restelli/aom-driver/kicad/aom_simple_1.kicad_sch

## KiCad design kicad/aom_simple_1.kicad_sch (2022-05-25)

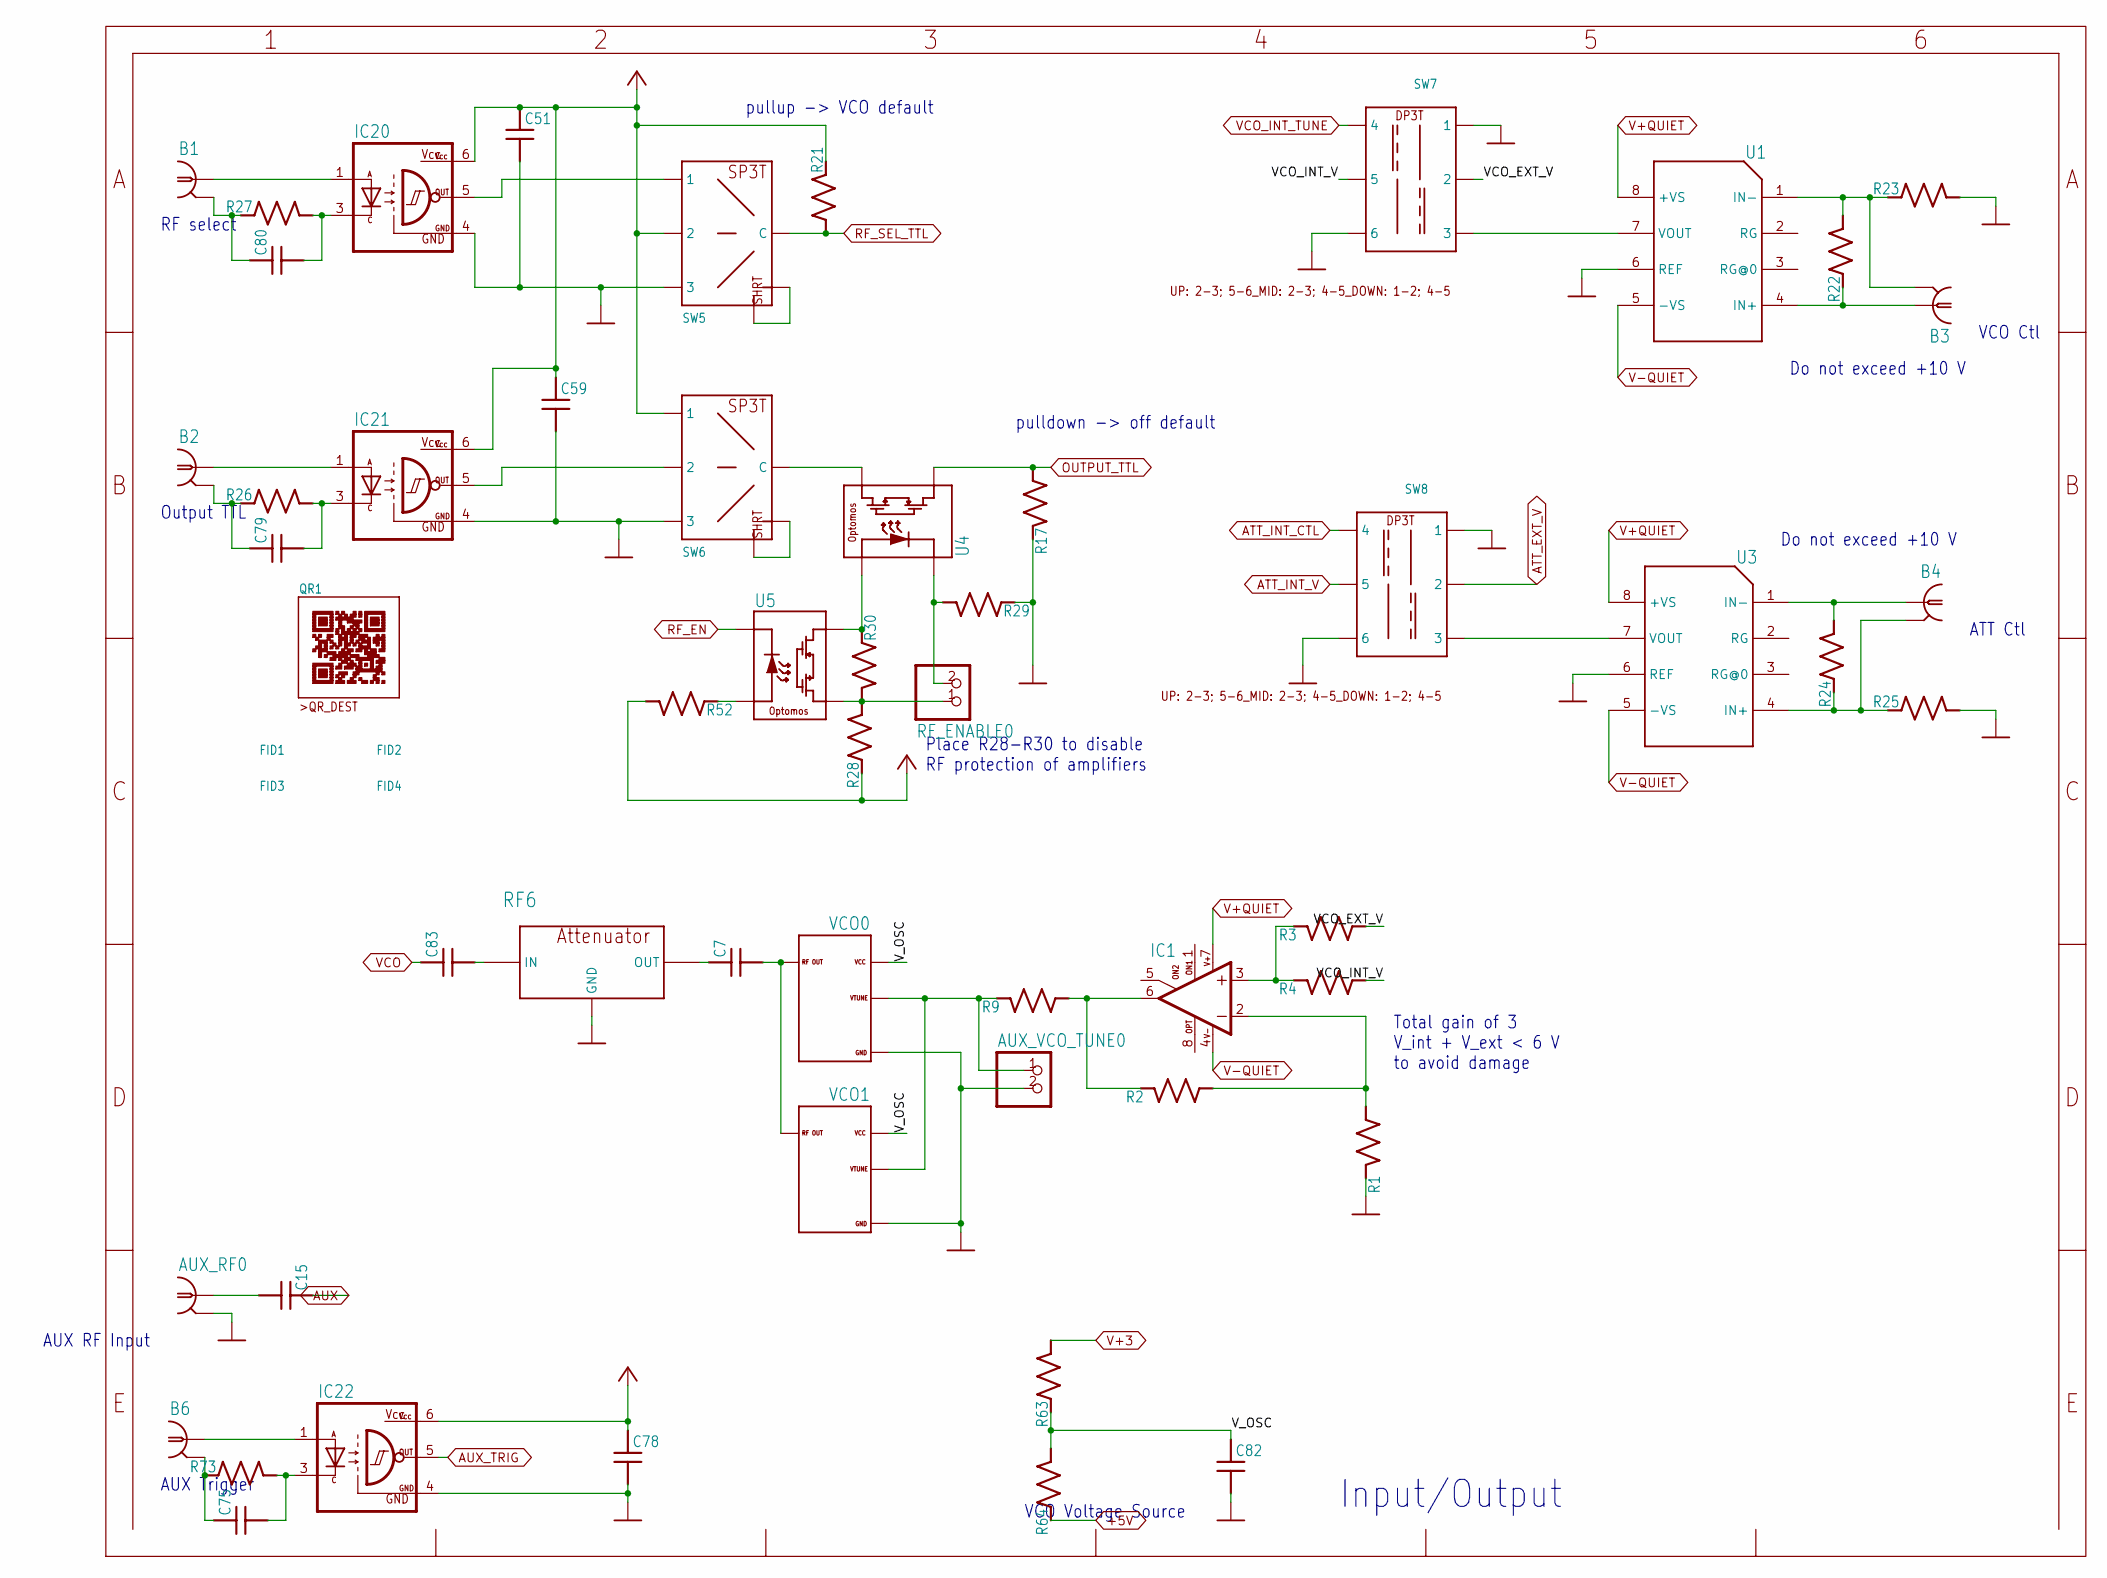
[picture p1: schematic aom_simple_1.kicad_sch]

Parts:
AUX_RF0: (no value)
AUX_VCO_TUNE0: (no value)
B1, B2, B3, B4, B6: (no value)
C7, C15, C51, C59, C75, C78, C79, C80, C82, C83: (no value)
FID1, FID2, FID3, FID4: (no value)
IC1, IC20, IC21, IC22: (no value)
QR1: (no value)
R1, R2, R3, R4, R9, R17, R21, R22, R23, R24, R25, R26, R27, R28, R29, R30, R52, R63, R64, R73: (no value)
RF6: (no value)
RF_ENABLE0: (no value)
SW5, SW6, SW7, SW8: (no value)
U1, U3, U4, U5: (no value)
VCO0, VCO1: (no value)

Connections:
+5V: R64.P$1 (1)
ATT_EXT_V: SW8.2
ATT_INT_CTL: SW8.4
ATT_INT_V: SW8.5
AUX: C15.P$1 (1)
AUX_TRIG: IC22.5 (OUT)
unnamed: AUX_RF0.GND1 (2), AUX_RF0.GND2 (2), AUX_RF0.GND3 (2), AUX_RF0.GND4 (2), AUX_VCO_TUNE0.2, C51.P$1 (1), C51.P$2 (2), C59.P$1 (1), C59.P$2 (2), C78.P$1 (1), C78.P$2 (2), C82.P$2 (2), IC20.4 (GND), IC20.6 (VCC), IC21.4 (GND), IC21.6 (VCC), IC22.4 (GND), IC22.6 (VCC), R1.P$1 (1), R17.P$1 (1), R21.P$1 (1), R23.P$2 (2), R25.P$2 (2), R28.P$1 (1), R29.P$1 (1), R52.P$2 (2), RF6.3 (GND), SW5.1 (3), SW5.4 (2), SW6.1 (3), SW6.6 (1), SW7.1, SW7.6, SW8.1, SW8.6, U1.6 (REF), U3.6 (REF), VCO0.1 (7-GND), VCO0.3 (7-GND), VCO0.4 (7-GND), VCO0.6 (7-GND), VCO0.7 (7-GND), VCO0.8 (7-GND), VCO0.9 (7-GND), VCO0.10 (7-GND), VCO0.11 (7-GND), VCO0.12 (7-GND), VCO0.14 (7-GND), VCO1.1 (7-GND), VCO1.3 (7-GND), VCO1.4 (7-GND), VCO1.5 (7-GND), VCO1.6 (7-GND), VCO1.7 (7-GND), VCO1.8 (7-GND), VCO1.9 (7-GND), VCO1.11 (7-GND), VCO1.12 (7-GND), VCO1.13 (7-GND), VCO1.15 (7-GND), VCO1.16 (7-GND)
unnamed: AUX_RF0.RF (1), C15.P$2 (2)
unnamed: AUX_VCO_TUNE0.1, R9.P$1 (1), VCO0.5 (5-VTUNE), VCO1.2 (5-VTUNE)
unnamed: B1.1, IC20.1 (A)
unnamed: B1.2, C80.P$1 (1), R27.P$1 (1)
unnamed: B2.1, IC21.1 (A)
unnamed: B2.2, C79.P$1 (1), R26.P$1 (1)
unnamed: B3.1, R22.P$1 (1), U1.4 (IN+)
unnamed: B3.2, R22.P$2 (2), R23.P$1 (1), U1.1 (IN-)
unnamed: B4.1, R24.P$2 (2), U3.1 (IN-)
unnamed: B4.2, R24.P$1 (1), R25.P$1 (1), U3.4 (IN+)
unnamed: B6.1, IC22.1 (A)
unnamed: B6.2, C75.P$1 (1), R73.P$1 (1)
unnamed: C7.P$1 (1), RF6.2 (OUT)
unnamed: C7.P$2 (2), VCO0.13 (13-RFOUT), VCO1.10 (13-RFOUT)
unnamed: C75.P$2 (2), IC22.3 (C), R73.P$2 (2)
unnamed: C79.P$2 (2), IC21.3 (C), R26.P$2 (2)
unnamed: C80.P$2 (2), IC20.3 (C), R27.P$2 (2)
unnamed: C83.P$2 (2), RF6.1 (IN)
unnamed: IC1.2 (-IN), R1.P$2 (2), R2.P$2 (2)
unnamed: IC1.3 (+IN), R3.P$1 (1), R4.P$1 (1)
unnamed: IC1.6 (OUT), R2.P$1 (1), R9.P$2 (2)
unnamed: IC20.5 (OUT), SW5.6 (1)
unnamed: IC21.5 (OUT), SW6.4 (2)
unnamed: R28.P$2 (2), R30.P$2 (2), RF_ENABLE0.1, U5.P$4 (L+)
unnamed: R29.P$2 (2), RF_ENABLE0.2, U4.P$2 (C-)
unnamed: R30.P$1 (1), U4.P$1 (C+), U5.P$3 (L-)
unnamed: R52.P$1 (1), U5.P$1 (C+)
unnamed: SW5.3 (D), SW5.5 (E)
unnamed: SW6.2 (C), U4.P$4 (L+)
unnamed: SW6.3 (D), SW6.5 (E)
unnamed: SW7.3, U1.7 (VOUT)
unnamed: SW8.3, U3.7 (VOUT)
OUTPUT_TTL: R17.P$2 (2), U4.P$3 (L-)
RF_EN: U5.P$2 (C-)
RF_SEL_TTL: R21.P$2 (2), SW5.2 (C)
V+3: R63.P$2 (2)
V+QUIET: IC1.7 (V+), U1.8 (+VS), U3.8 (+VS)
V-QUIET: IC1.4 (V-), U1.5 (-VS), U3.5 (-VS)
VCO: C83.P$1 (1)
VCO_EXT_V: R3.P$2 (2), SW7.2
VCO_INT_TUNE: SW7.4
VCO_INT_V: R4.P$2 (2), SW7.5
V_OSC: C82.P$1 (1), R63.P$1 (1), R64.P$2 (2), VCO0.2 (2-VCC), VCO1.14 (2-VCC)

Notes on the sheet:
AUX Trigger
Do not exceed +10 V
AUX RF Input
RF select
ATT Ctl
pullup -> VCO default
VCO Voltage Source
Place R28-R30 to disable RF protection of amplifiers
VCO Ctl
Output TTL
Total gain of 3 V_int + V_ext < 6 V to avoid damage
pulldown -> off default
Input/Output
