restelli/aom-driver/kicad/aom_simple_2.kicad_sch

## KiCad design kicad/aom_simple_2.kicad_sch (2022-05-25)

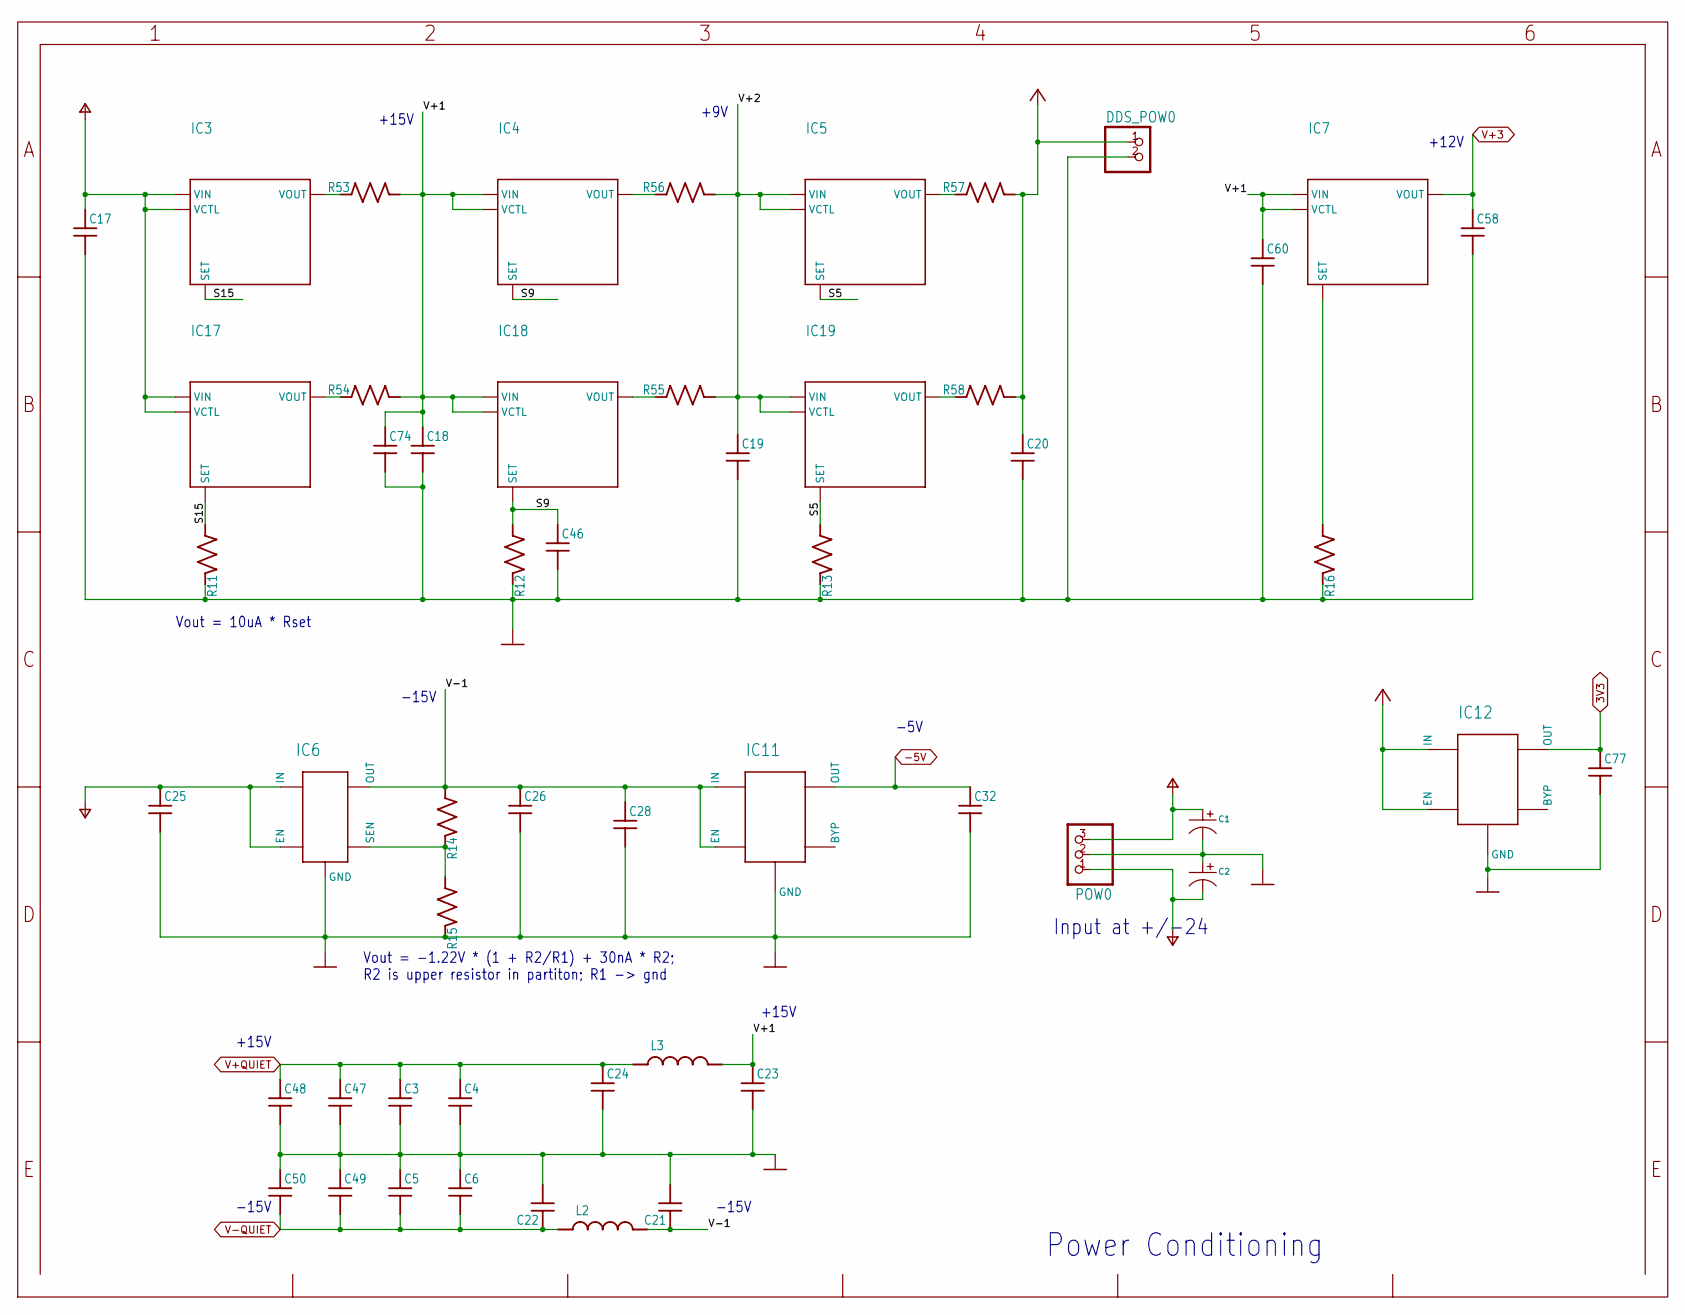
[picture p2: schematic aom_simple_2.kicad_sch]

Parts:
C1, C2, C3, C4, C5, C6, C17, C18, C19, C20, C21, C22, C23, C24, C25, C26, C28, C32, C46, C47, C48, C49, C50, C58, C60, C74, C77: (no value)
DDS_POW0: (no value)
IC3, IC4, IC5, IC6, IC7, IC11, IC12, IC17, IC18, IC19: (no value)
L2, L3: (no value)
POW0: (no value)
R11, R12, R13, R14, R15, R16, R53, R54, R55, R56, R57, R58: (no value)

Connections:
3V3: C77.P$1 (1), IC12.5 (OUT)
-5V: C32.P$1 (1), IC11.5 (OUT)
unnamed: C1.P$1, C1.P$2, C2.P$1, C2.P$2, C3.P$2 (2), C4.P$2 (2), C5.P$1 (1), C6.P$1 (1), C17.P$1 (1), C17.P$2 (2), C18.P$2 (2), C19.P$2 (2), C20.P$1 (1), C20.P$2 (2), C21.P$2 (2), C22.P$2 (2), C23.P$2 (2), C24.P$2 (2), C25.P$1 (1), C25.P$2 (2), C26.P$2 (2), C28.P$2 (2), C32.P$2 (2), C46.P$2 (2), C47.P$2 (2), C48.P$2 (2), C49.P$1 (1), C50.P$1 (1), C58.P$2 (2), C60.P$2 (2), C74.P$2 (2), C77.P$2 (2), DDS_POW0.1, DDS_POW0.2, IC3.4 (VCTL), IC3.5 (VIN), IC6.1 (EN), IC6.2 (GND), IC6.3 (IN), IC6.6 (IN), IC11.1 (GND), IC12.1 (IN), IC12.2 (GND), IC12.3 (EN), IC17.4 (VCTL), IC17.5 (VIN), POW0.1, POW0.2, POW0.3, R11.P$1 (1), R12.P$1 (1), R13.P$1 (1), R15.P$1 (1), R16.P$1 (1), R57.P$2 (2), R58.P$2 (2)
unnamed: IC3.3 (VOUT), IC3.6 (VOUT), R53.P$1 (1)
unnamed: IC4.3 (VOUT), IC4.6 (VOUT), R56.P$1 (1)
unnamed: IC5.3 (VOUT), IC5.6 (VOUT), R57.P$1 (1)
unnamed: IC6.4 (SEN), R14.P$1 (1), R15.P$2 (2)
unnamed: IC7.2 (SET), R16.P$2 (2)
unnamed: IC17.3 (VOUT), IC17.6 (VOUT), R54.P$1 (1)
unnamed: IC18.3 (VOUT), IC18.6 (VOUT), R55.P$1 (1)
unnamed: IC19.3 (VOUT), IC19.6 (VOUT), R58.P$1 (1)
S5: IC5.2 (SET), IC19.2 (SET), R13.P$2 (2)
S9: C46.P$1 (1), IC4.2 (SET), IC18.2 (SET), R12.P$2 (2)
S15: IC3.2 (SET), IC17.2 (SET), R11.P$2 (2)
V+1: C18.P$1 (1), C23.P$1 (1), C60.P$1 (1), C74.P$1 (1), IC4.4 (VCTL), IC4.5 (VIN), IC7.4 (VCTL), IC7.5 (VIN), IC18.4 (VCTL), IC18.5 (VIN), L3.P$2 (2), R53.P$2 (2), R54.P$2 (2)
V+2: C19.P$1 (1), IC5.4 (VCTL), IC5.5 (VIN), IC19.4 (VCTL), IC19.5 (VIN), R55.P$2 (2), R56.P$2 (2)
V+3: C58.P$1 (1), IC7.3 (VOUT), IC7.6 (VOUT)
V+QUIET: C3.P$1 (1), C4.P$1 (1), C24.P$1 (1), C47.P$1 (1), C48.P$1 (1), L3.P$1 (1)
V-1: C21.P$1 (1), C26.P$1 (1), C28.P$1 (1), IC6.5 (OUT), IC11.2 (IN), IC11.4 (EN), L2.P$2 (2), R14.P$2 (2)
V-QUIET: C5.P$2 (2), C6.P$2 (2), C22.P$1 (1), C49.P$2 (2), C50.P$2 (2), L2.P$1 (1)

Notes on the sheet:
Vout = -1.22V * (1 + R2/R1) + 30nA * R2; R2 is upper resistor in partiton; R1 -> gnd
+15V
-15V
Input at +/-24
+12V
Vout = 10uA * Rset
-5V
Power Conditioning
+9V
