restelli/aom-driver/kicad/aom_simple_3.kicad_sch

## KiCad design kicad/aom_simple_3.kicad_sch (2022-05-25)

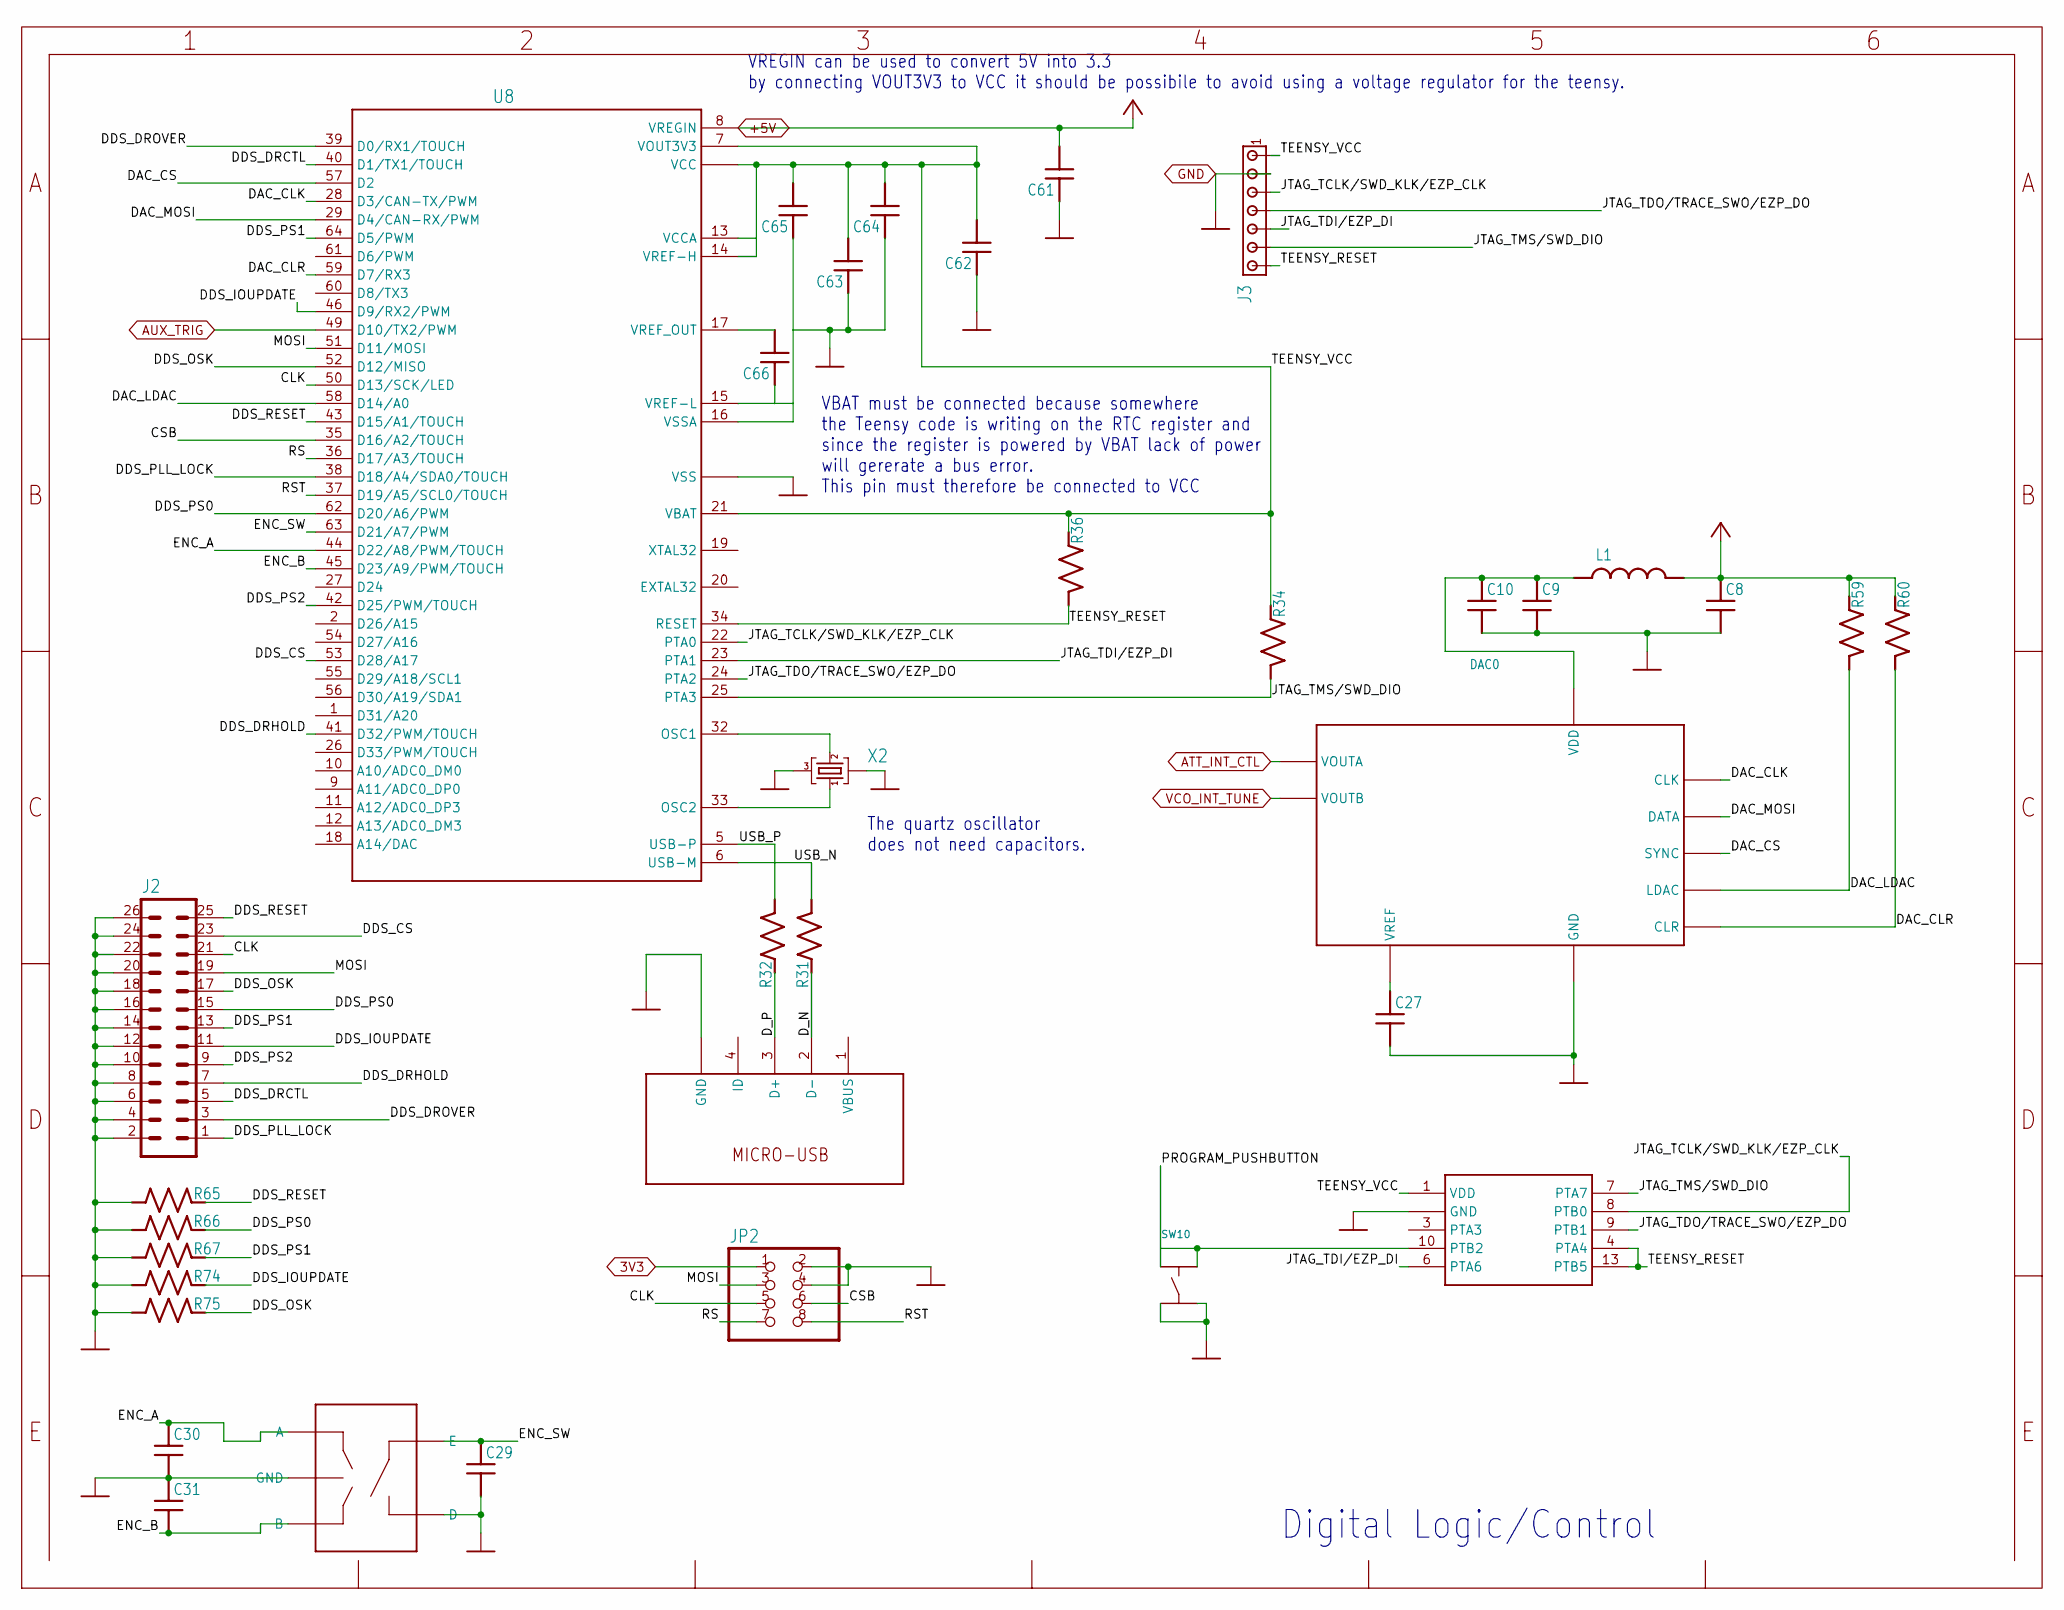
[picture p3: schematic aom_simple_3.kicad_sch]

Parts:
C8, C9, C10, C27, C29, C30, C31, C61, C62, C63, C64, C65, C66: (no value)
DAC0: (no value)
ENC1: (no value)
J2, J3: (no value)
JP2: (no value)
L1: (no value)
R31, R32, R34, R36, R59, R60, R65, R66, R67, R74, R75: (no value)
SW10: (no value)
U8: (no value)
UNK3X3MM1: (no value)
USB1: (no value)
X2: (no value)

Connections:
3V3: JP2.1
+5V: C8.P$1 (1), C8.P$2 (2), C9.P$2 (2), C10.P$2 (2), C27.P$2 (2), C29.P$2 (2), C30.P$2 (2), C31.P$1 (1), C61.P$1 (1), C61.P$2 (2), C62.P$1 (1), C63.P$1 (1), C64.P$1 (1), C65.P$1 (1), C66.P$1 (1), DAC0.3 (GND), ENC1.2 (D), ENC1.C (GND), J2.2, J2.4, J2.6, J2.8, J2.10, J2.12, J2.14, J2.16, J2.18, J2.20, J2.22, J2.24, J2.26, J3.P$2 (2), JP2.2, JP2.4, L1.P$2 (2), R59.P$1 (1), R60.P$1 (1), R65.P$2 (2), R66.P$2 (2), R67.P$2 (2), R74.P$2 (2), R75.P$2 (2), SW10.P$3, SW10.P$4, U8.4 (VSS), U8.8 (VREGIN), U8.15 (VREF-L), U8.16 (VSSA), U8.31 (VSS), U8.47 (VSS), UNK3X3MM1.2 (GND), UNK3X3MM1.17 (GND), USB1.5 (GND), USB1.P$1 (GND), USB1.P$2 (GND), USB1.P$3 (GND), X2.2 (GND@1), X2.4 (GND@2)
ATT_INT_CTL: DAC0.1 (VOUTA)
AUX_TRIG: U8.49 (D10/TX2/PWM)
CLK: J2.21, JP2.5, U8.50 (D13/SCK/LED)
CSB: JP2.6, U8.35 (D16/A2/TOUCH)
DAC_CLK: DAC0.7 (CLK), U8.28 (D3/CAN-TX/PWM)
DAC_CLR: DAC0.5 (CLR), R60.P$2 (2), U8.59 (D7/RX3)
DAC_CS: DAC0.6 (SYNC), U8.57 (D2)
DAC_LDAC: DAC0.4 (LDAC), R59.P$2 (2), U8.58 (D14/A0)
DAC_MOSI: DAC0.8 (DATA), U8.29 (D4/CAN-RX/PWM)
DDS_CS: J2.23, U8.53 (D28/A17)
DDS_DRCTL: J2.5, U8.40 (D1/TX1/TOUCH)
DDS_DRHOLD: J2.7, U8.41 (D32/PWM/TOUCH)
DDS_DROVER: J2.3, U8.39 (D0/RX1/TOUCH)
DDS_IOUPDATE: J2.11, R74.P$1 (1), U8.46 (D9/RX2/PWM)
DDS_OSK: J2.17, R75.P$1 (1), U8.52 (D12/MISO)
DDS_PLL_LOCK: J2.1, U8.38 (D18/A4/SDA0/TOUCH)
DDS_PS0: J2.15, R66.P$1 (1), U8.62 (D20/A6/PWM)
DDS_PS1: J2.13, R67.P$1 (1), U8.64 (D5/PWM)
DDS_PS2: J2.9, U8.42 (D25/PWM/TOUCH)
DDS_RESET: J2.25, R65.P$1 (1), U8.43 (D15/A1/TOUCH)
D_N: R31.P$1 (1), USB1.2 (D-)
D_P: R32.P$1 (1), USB1.3 (D+)
ENC_A: C30.P$1 (1), ENC1.A, U8.44 (D22/A8/PWM/TOUCH)
ENC_B: C31.P$2 (2), ENC1.B, U8.45 (D23/A9/PWM/TOUCH)
ENC_SW: C29.P$1 (1), ENC1.1 (E), U8.63 (D21/A7/PWM)
JTAG_TCLK/SWD_KLK/EZP_CLK: J3.P$3 (3), U8.22 (PTA0), UNK3X3MM1.8 (PTB0)
JTAG_TDI/EZP_DI: J3.P$5 (5), U8.23 (PTA1), UNK3X3MM1.6 (PTA6)
JTAG_TDO/TRACE_SWO/EZP_DO: J3.P$4 (4), U8.24 (PTA2), UNK3X3MM1.9 (PTB1)
JTAG_TMS/SWD_DIO: J3.P$6 (6), R34.P$2 (2), U8.25 (PTA3), UNK3X3MM1.7 (PTA7)
MOSI: J2.19, JP2.3, U8.51 (D11/MOSI)
unnamed: C9.P$1 (1), C10.P$1 (1), DAC0.9 (VDD), L1.P$1 (1)
unnamed: C27.P$1 (1), DAC0.10 (VREF)
unnamed: C66.P$2 (2), U8.17 (VREF_OUT)
unnamed: U8.32 (OSC1), X2.3 (C2)
unnamed: U8.33 (OSC2), X2.1 (C1)
PROGRAM_PUSHBUTTON: SW10.P$1, SW10.P$2, UNK3X3MM1.10 (PTB2)
RS: JP2.7, U8.36 (D17/A3/TOUCH)
RST: JP2.8, U8.37 (D19/A5/SCL0/TOUCH)
TEENSY_RESET: J3.P$7 (7), R36.P$2 (2), U8.34 (RESET), UNK3X3MM1.4 (PTA4), UNK3X3MM1.13 (PTB5)
TEENSY_VCC: C62.P$2 (2), C63.P$2 (2), C64.P$2 (2), C65.P$2 (2), J3.P$1 (1), R34.P$1 (1), R36.P$1 (1), U8.3 (VCC), U8.7 (VOUT3V3), U8.13 (VCCA), U8.14 (VREF-H), U8.21 (VBAT), U8.30 (VCC), U8.48 (VCC), UNK3X3MM1.1 (VDD)
USB_N: R31.P$2 (2), U8.6 (USB-M)
USB_P: R32.P$2 (2), U8.5 (USB-P)
VCO_INT_TUNE: DAC0.2 (VOUTB)

Notes on the sheet:
VREGIN can be used to convert 5V into 3.3 by connecting VOUT3V3 to VCC it should be possibile to avoid using a voltage regulator for the teensy.
VBAT must be connected because somewhere the Teensy code is writing on the RTC register and since the register is powered by VBAT lack of power will gererate a bus error. This pin must therefore be connected to VCC
The quartz oscillator does not need capacitors.
Digital Logic/Control
