restelli/aom-driver/kicad/aom_simple_4.kicad_sch

## KiCad design kicad/aom_simple_4.kicad_sch (2022-05-25)

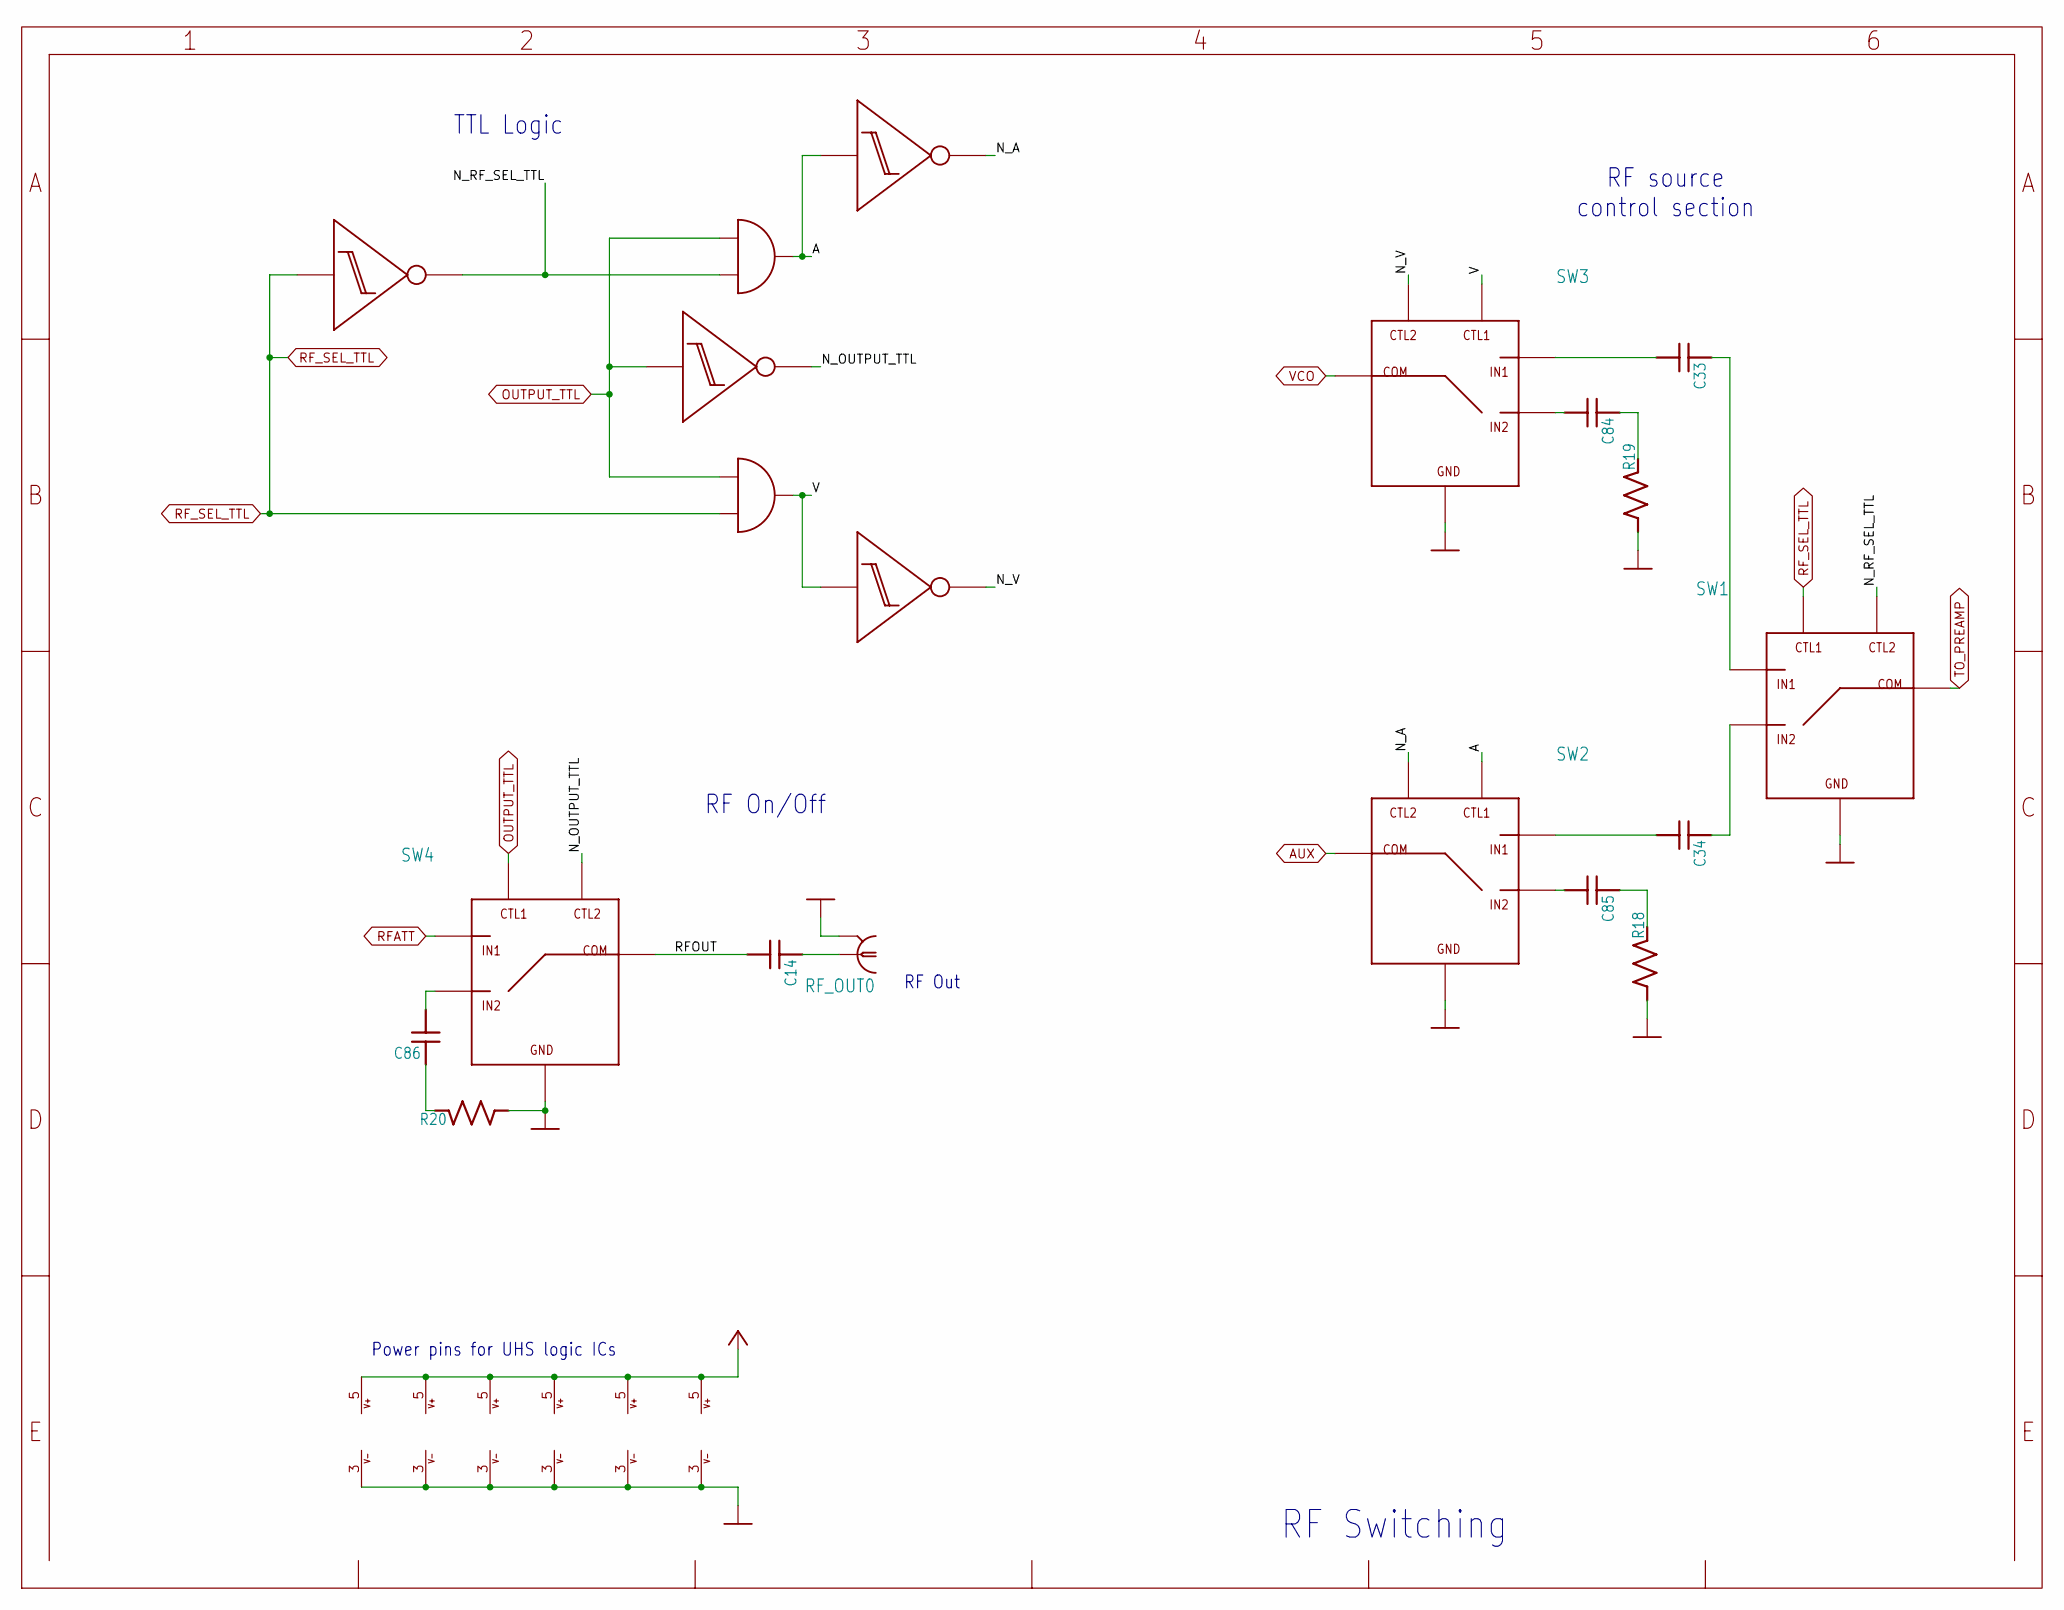
[picture p4: schematic aom_simple_4.kicad_sch]

Parts:
C14, C33, C34, C84, C85, C86: (no value)
IC8, IC9, IC10, IC13, IC14, IC15: (no value)
R18, R19, R20: (no value)
RF_OUT0: (no value)
SW1, SW2, SW3, SW4: (no value)

Connections:
A: IC9.4 (OUT), IC13.2 (IN), SW2.1 (CTL1)
AUX: SW2.3 (COM)
N_A: IC13.4 (OUT), SW2.2 (CTL2)
N_OUTPUT_TTL: IC15.4 (OUT), SW4.2 (CTL2)
N_RF_SEL_TTL: IC8.4 (OUT), IC9.2 (INB), SW1.2 (CTL2)
N_V: IC14.4 (OUT), SW3.2 (CTL2)
unnamed: C14.P$1 (1), RF_OUT0.RF (1)
unnamed: C33.P$1 (1), SW1.8 (IN1)
unnamed: C33.P$2 (2), SW3.8 (IN1)
unnamed: C34.P$1 (1), SW1.5 (IN2)
unnamed: C34.P$2 (2), SW2.8 (IN1)
unnamed: C84.P$1 (1), R19.P$1 (1)
unnamed: C84.P$2 (2), SW3.5 (IN2)
unnamed: C85.P$1 (1), R18.P$1 (1)
unnamed: C85.P$2 (2), SW2.5 (IN2)
unnamed: C86.P$1 (1), R20.P$1 (1)
unnamed: C86.P$2 (2), SW4.5 (IN2)
unnamed: IC8.3 (V-), IC8.5 (V+), IC9.3 (V-), IC9.5 (V+), IC10.3 (V-), IC10.5 (V+), IC13.3 (V-), IC13.5 (V+), IC14.3 (V-), IC14.5 (V+), IC15.3 (V-), IC15.5 (V+), R18.P$2 (2), R19.P$2 (2), R20.P$2 (2), RF_OUT0.GND1 (2), RF_OUT0.GND2 (2), RF_OUT0.GND3 (2), RF_OUT0.GND4 (2), SW1.4 (GND), SW1.6 (GND), SW1.7 (GND), SW1.EP1 (GND), SW1.EP2 (GND), SW1.EP3 (GND), SW1.EP4 (GND), SW1.EP5 (GND), SW1.EP6 (GND), SW2.4 (GND), SW2.6 (GND), SW2.7 (GND), SW2.EP1 (GND), SW2.EP2 (GND), SW2.EP3 (GND), SW2.EP4 (GND), SW2.EP5 (GND), SW2.EP6 (GND), SW3.4 (GND), SW3.6 (GND), SW3.7 (GND), SW3.EP1 (GND), SW3.EP2 (GND), SW3.EP3 (GND), SW3.EP4 (GND), SW3.EP5 (GND), SW3.EP6 (GND), SW4.4 (GND), SW4.6 (GND), SW4.7 (GND), SW4.EP1 (GND), SW4.EP2 (GND), SW4.EP3 (GND), SW4.EP4 (GND), SW4.EP5 (GND), SW4.EP6 (GND)
OUTPUT_TTL: IC9.1 (INA), IC10.1 (INA), IC15.2 (IN), SW4.1 (CTL1)
RFATT: SW4.8 (IN1)
RFOUT: C14.P$2 (2), SW4.3 (COM)
RF_SEL_TTL: IC8.2 (IN), IC10.2 (INB), SW1.1 (CTL1)
TO_PREAMP: SW1.3 (COM)
V: IC10.4 (OUT), IC14.2 (IN), SW3.1 (CTL1)
VCO: SW3.3 (COM)

Notes on the sheet:
Power pins for UHS logic ICs
RF Switching
RF Out
RF On/Off
TTL Logic
RF source control section
