restelli/aom-driver/kicad/aom_simple_5.kicad_sch

## KiCad design kicad/aom_simple_5.kicad_sch (2022-05-25)

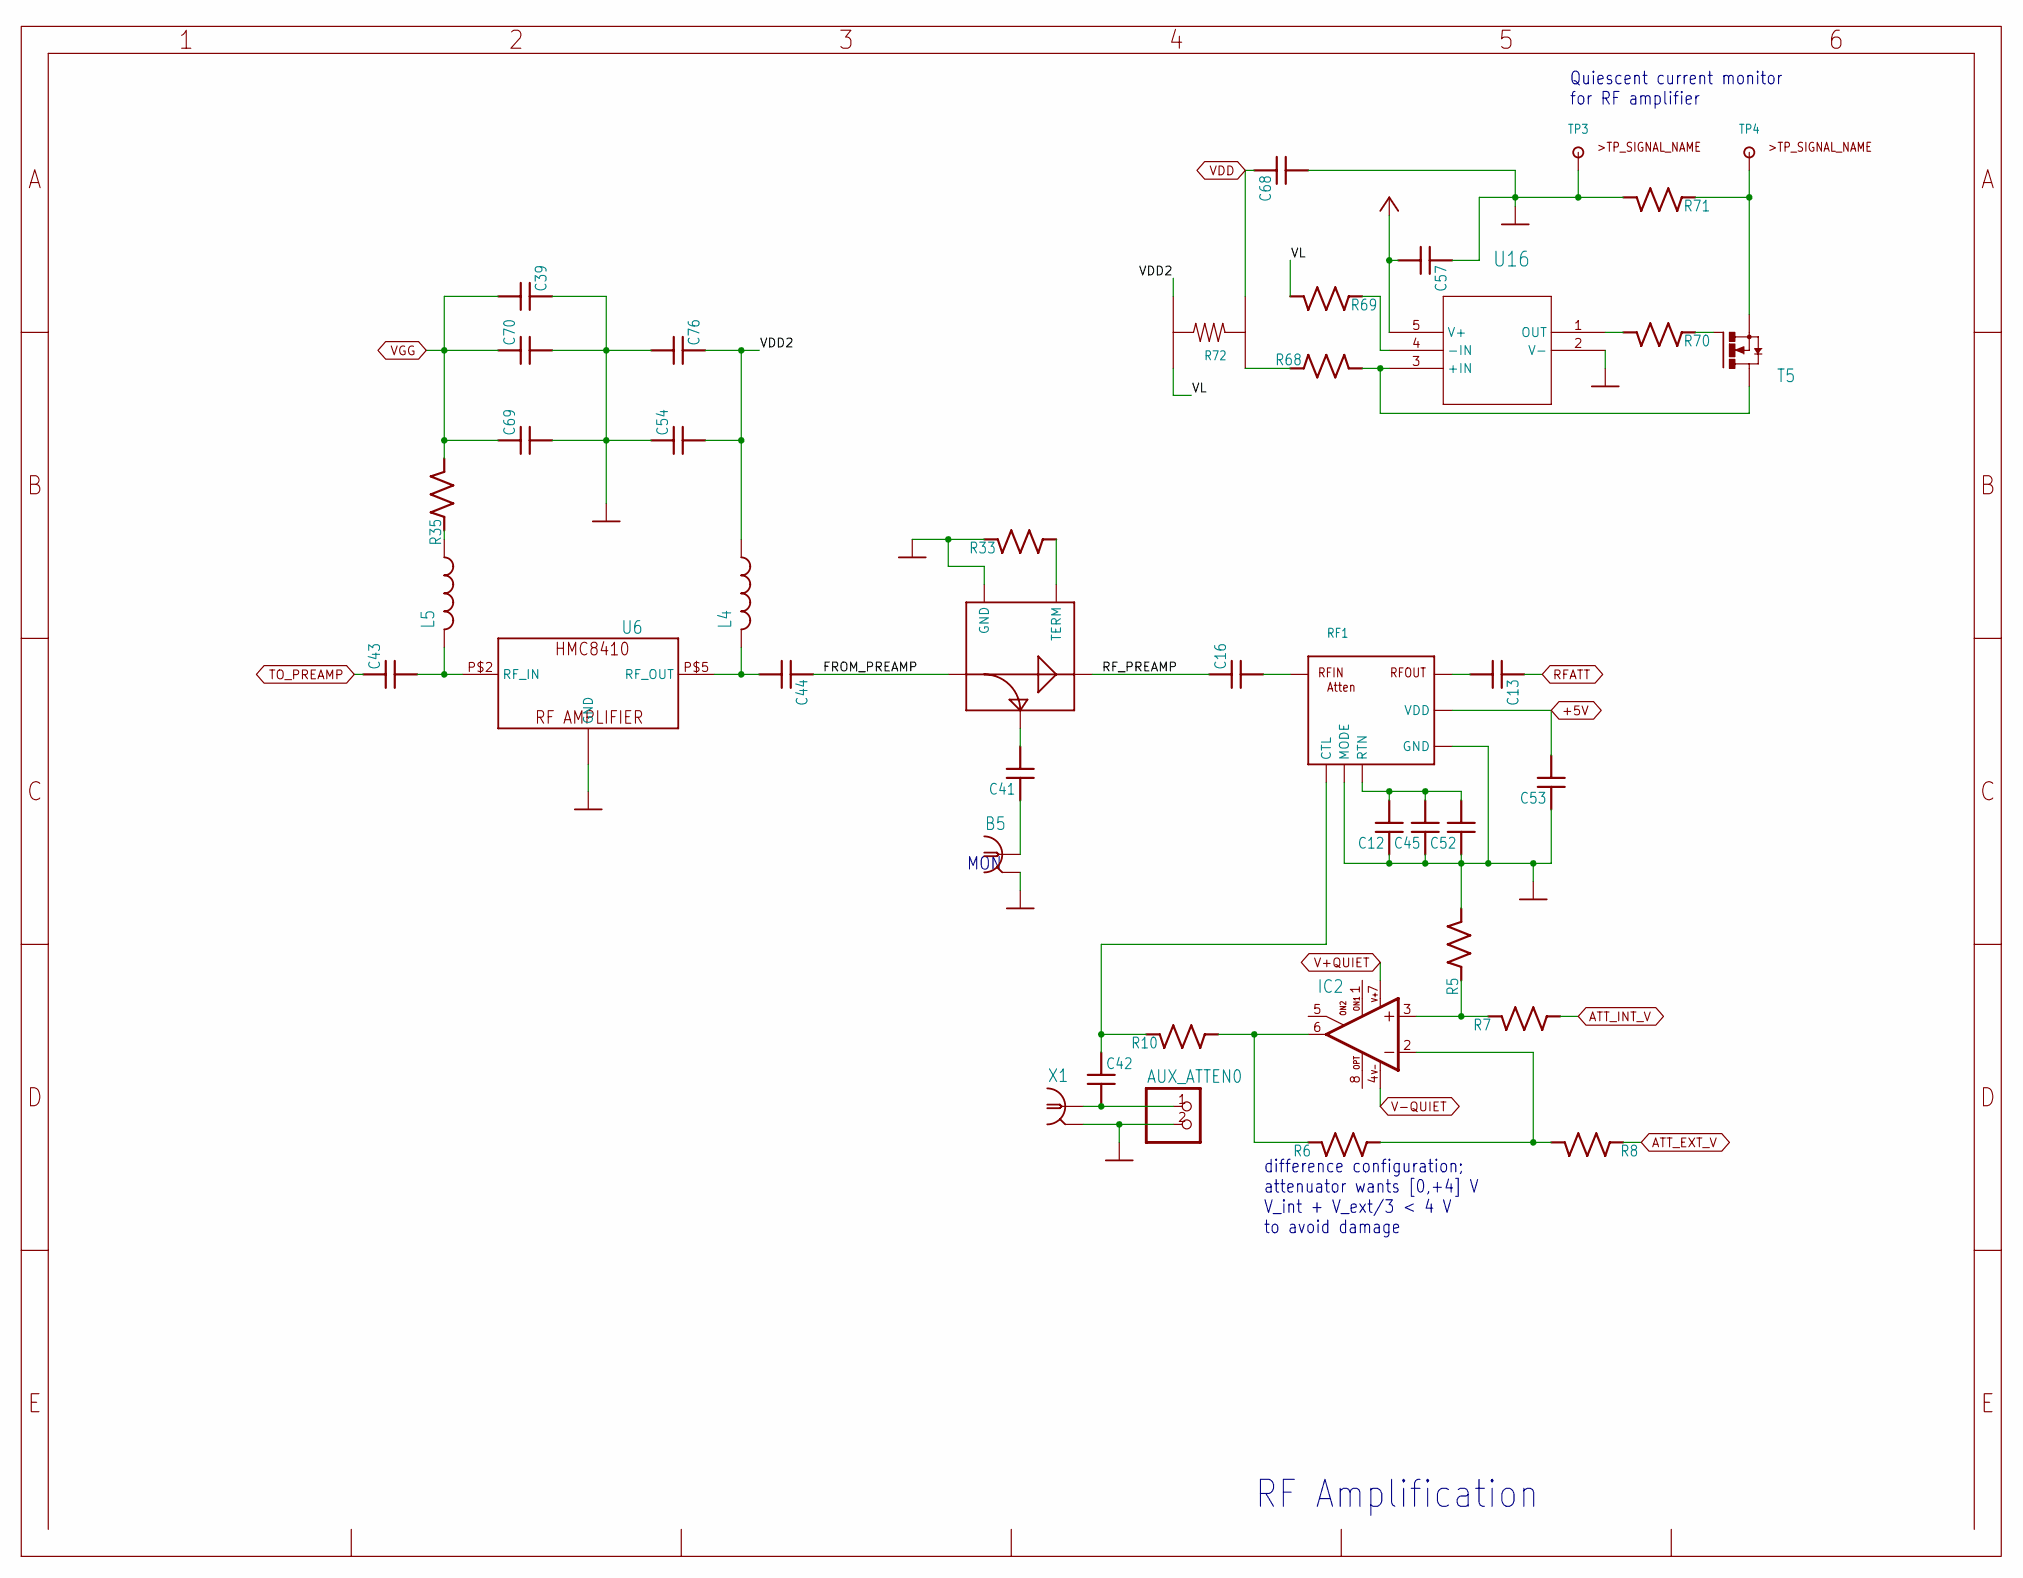
[picture p5: schematic aom_simple_5.kicad_sch]

Parts:
AUX_ATTEN0: (no value)
B5: (no value)
C12, C13, C16, C39, C41, C42, C43, C44, C45, C52, C53, C54, C57, C68, C69, C70, C76: (no value)
IC2: (no value)
L4, L5: (no value)
R5, R6, R7, R8, R10, R33, R35, R68, R69, R70, R71, R72: (no value)
RF1, RF5: (no value)
T5: (no value)
TP3, TP4: (no value)
U6, U16: (no value)
X1: (no value)

Connections:
+5V: C53.P$2 (2), RF1.15 (VDD)
ATT_EXT_V: R8.P$1 (1)
ATT_INT_V: R7.P$2 (2)
FROM_PREAMP: C44.P$1 (1), RF5.P1 (IN)
unnamed: AUX_ATTEN0.1, C42.P$2 (2), X1.P$1 (1)
unnamed: AUX_ATTEN0.2, B5.2, C12.P$1 (1), C39.P$1 (1), C45.P$1 (1), C52.P$1 (1), C53.P$1 (1), C54.P$1 (1), C57.P$1 (1), C57.P$2 (2), C68.P$2 (2), C69.P$2 (2), C70.P$2 (2), C76.P$2 (2), R5.P$2 (2), R33.P$1 (1), R71.P$2 (2), RF1.1 (GND), RF1.2 (GND), RF1.4 (GND), RF1.7 (GND), RF1.9 (GND), RF1.11 (GND), RF1.12 (GND), RF1.13 (GND), RF1.16 (MODE), RF1.17 (GND), RF1.18 (GND), RF1.19 (GND), RF1.20 (GND), RF1.21 (GND), RF5.P2 (GND), TP3.P$1, U6.P$1 (GND), U6.P$3 (GND), U6.P$4 (GND), U6.P$6 (GND), U6.P$7 (GND), U16.2 (V-), U16.5 (V+), X1.P$2 (2), X1.P$3 (2)
unnamed: B5.1, C41.P$1 (1)
unnamed: C12.P$2 (2), C45.P$2 (2), C52.P$2 (2), RF1.5 (RTN), RF1.6 (RTN), RF1.8 (RTN)
unnamed: C13.P$2 (2), RF1.10 (RFOUT)
unnamed: C16.P$2 (2), RF1.3 (RFIN)
unnamed: C41.P$2 (2), RF5.P3 (COUP)
unnamed: C42.P$1 (1), R10.P$1 (1), RF1.14 (CTL)
unnamed: C43.P$2 (2), L5.2, U6.P$2 (RF_IN)
unnamed: C44.P$2 (2), L4.2, U6.P$5 (RF_OUT)
unnamed: IC2.2 (-IN), R6.P$2 (2), R8.P$2 (2)
unnamed: IC2.3 (+IN), R5.P$1 (1), R7.P$1 (1)
unnamed: IC2.6 (OUT), R6.P$1 (1), R10.P$2 (2)
unnamed: L5.1, R35.P$1 (1)
unnamed: R33.P$2 (2), RF5.P4 (TERM)
unnamed: R68.P$1 (1), R72.P$1
unnamed: R68.P$2 (2), T5.2 (D), T5.4 (D), U16.3 (+IN)
unnamed: R69.P$1 (1), U16.4 (-IN)
unnamed: R70.P$1 (1), T5.1 (G)
unnamed: R70.P$2 (2), U16.1 (OUT)
unnamed: R71.P$1 (1), T5.3 (S), TP4.P$1
RFATT: C13.P$1 (1)
RF_PREAMP: C16.P$1 (1), RF5.P6 (OUT)
TO_PREAMP: C43.P$1 (1)
V+QUIET: IC2.7 (V+)
V-QUIET: IC2.4 (V-)
VDD: C68.P$1 (1), R72.P$3
VDD2: C54.P$2 (2), C76.P$1 (1), L4.1, R72.P$4
VGG: C39.P$2 (2), C69.P$1 (1), C70.P$1 (1), R35.P$2 (2)
VL: R69.P$2 (2), R72.P$2

Notes on the sheet:
RF Amplification
difference configuration; attenuator wants [0,+4] V V_int + V_ext/3 < 4 V to avoid damage
Quiescent current monitor for RF amplifier
MON
