restelli/aom-driver/kicad/aom_simple_6.kicad_sch

## KiCad design kicad/aom_simple_6.kicad_sch (2022-05-25)

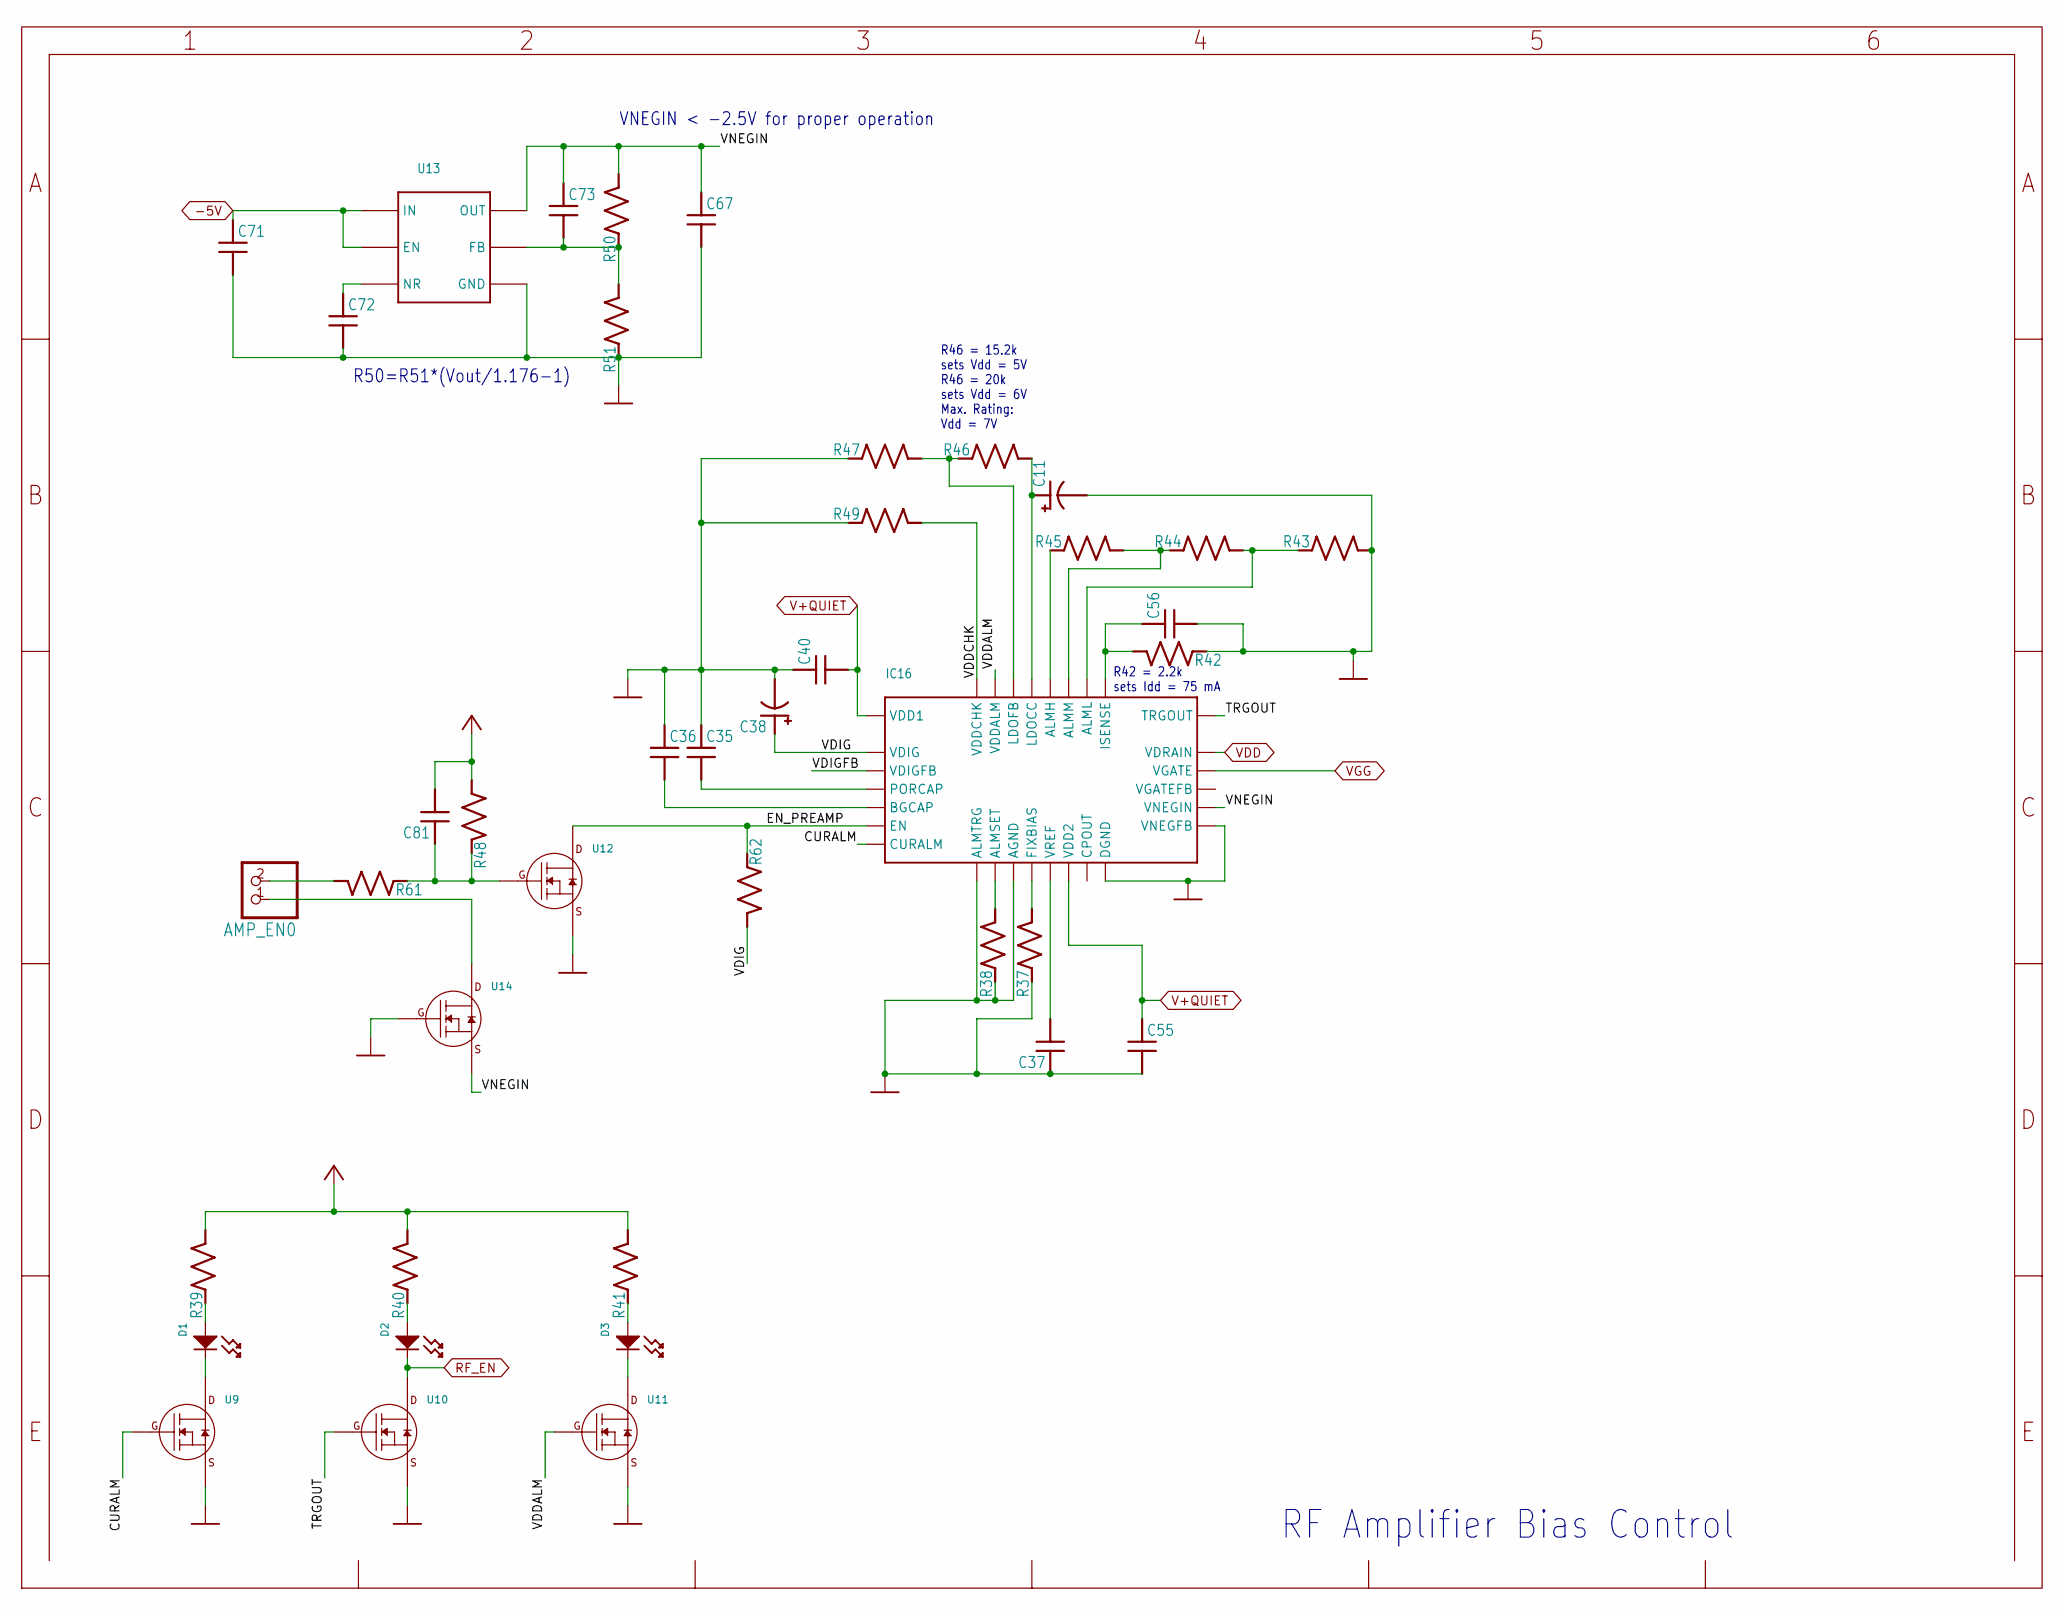
[picture p6: schematic aom_simple_6.kicad_sch]

Parts:
AMP_EN0: (no value)
C11, C35, C36, C37, C38, C40, C55, C56, C67, C71, C72, C73, C81: (no value)
D1, D2, D3: (no value)
IC16: (no value)
R37, R38, R39, R40, R41, R42, R43, R44, R45, R46, R47, R48, R49, R50, R51, R61, R62: (no value)
U9, U10, U11, U12, U13, U14: (no value)

Connections:
-5V: C71.P$1 (1), U13.EN, U13.IN
CURALM: IC16.8 (CURALM), U9.P$1 (GATE)
EN_PREAMP: IC16.7 (EN), R62.P$1 (1), U12.P$3 (DRAIN)
unnamed: AMP_EN0.1, U14.P$3 (DRAIN)
unnamed: AMP_EN0.2, R61.P$2 (2)
unnamed: C11.P$1 (+), IC16.29 (LDOCC), R46.P$2 (2)
unnamed: C11.P$2 (-), C35.P$1 (1), C36.P$1 (1), C37.P$1 (1), C38.P$2 (-), C40.P$1 (1), C55.P$2 (2), C56.P$2 (2), C67.P$2 (2), C71.P$2 (2), C72.P$2 (2), C81.P$2 (2), IC16.9 (ALMTRG), IC16.11 (AGND), IC16.16 (DGND), IC16.17 (AGND), IC16.18 (VNEGFB), IC16.33 (AGND), IC16.34 (AGND), IC16.35 (AGND), IC16.36 (AGND), IC16.37 (AGND), IC16.38 (AGND), IC16.39 (AGND), IC16.40 (AGND), IC16.41 (AGND), IC16.42 (AGND), R37.P$1 (1), R38.P$1 (1), R39.P$2 (2), R40.P$2 (2), R41.P$2 (2), R42.P$1 (1), R43.P$2 (2), R47.P$1 (1), R48.P$2 (2), R49.P$1 (1), R51.P$1 (1), U9.P$2 (SOURCE), U10.P$2 (SOURCE), U11.P$2 (SOURCE), U12.P$2 (SOURCE), U13.GND, U13.GND1 (GND), U14.P$1 (GATE)
unnamed: C35.P$2 (2), IC16.5 (PORCAP)
unnamed: C36.P$2 (2), IC16.6 (BGCAP)
unnamed: C37.P$2 (2), IC16.13 (VREF)
unnamed: C56.P$1 (1), IC16.25 (ISENSE), R42.P$2 (2)
unnamed: C72.P$1 (1), U13.NR/SS (NR)
unnamed: C73.P$2 (2), R50.P$1 (1), R51.P$2 (2), U13.FB
unnamed: C81.P$1 (1), R48.P$1 (1), R61.P$1 (1), U12.P$1 (GATE)
unnamed: D1.ANODE, R39.P$1 (1)
unnamed: D1.CATHODE, U9.P$3 (DRAIN)
unnamed: D2.ANODE, R40.P$1 (1)
unnamed: D3.ANODE, R41.P$1 (1)
unnamed: D3.CATHODE, U11.P$3 (DRAIN)
unnamed: IC16.10 (ALMSET), R38.P$2 (2)
unnamed: IC16.12 (FIXBIAS), R37.P$2 (2)
unnamed: IC16.26 (ALML), R43.P$1 (1), R44.P$2 (2)
unnamed: IC16.27 (ALMM), R44.P$1 (1), R45.P$2 (2)
unnamed: IC16.28 (ALMH), R45.P$1 (1)
unnamed: IC16.30 (LDOFB), R46.P$1 (1), R47.P$2 (2)
RF_EN: D2.CATHODE, U10.P$3 (DRAIN)
TRGOUT: IC16.24 (TRGOUT), U10.P$1 (GATE)
V+QUIET: C40.P$2 (2), C55.P$1 (1), IC16.1 (VDD1), IC16.2 (VDD1), IC16.14 (VDD2)
VDD: IC16.22 (VDRAIN), IC16.23 (VDRAIN)
VDDALM: IC16.31 (VDDALM), U11.P$1 (GATE)
VDDCHK: IC16.32 (VDDCHK), R49.P$2 (2)
VDIG: C38.P$1 (+), IC16.3 (VDIG), R62.P$2 (2)
VDIGFB: IC16.4 (VDIGFB)
VGG: IC16.21 (VGATE)
VNEGIN: C67.P$1 (1), C73.P$1 (1), IC16.19 (VNEGIN), R50.P$2 (2), U13.OUT, U14.P$2 (SOURCE)

Notes on the sheet:
R50=R51*(Vout/1.176-1)
R46 = 15.2k sets Vdd = 5V R46 = 20k sets Vdd = 6V Max. Rating: Vdd = 7V
R42 = 2.2k sets Idd = 75 mA
VNEGIN < -2.5V for proper operation
RF Amplifier Bias Control
